galah-x/weatherino/weatherino.pdf

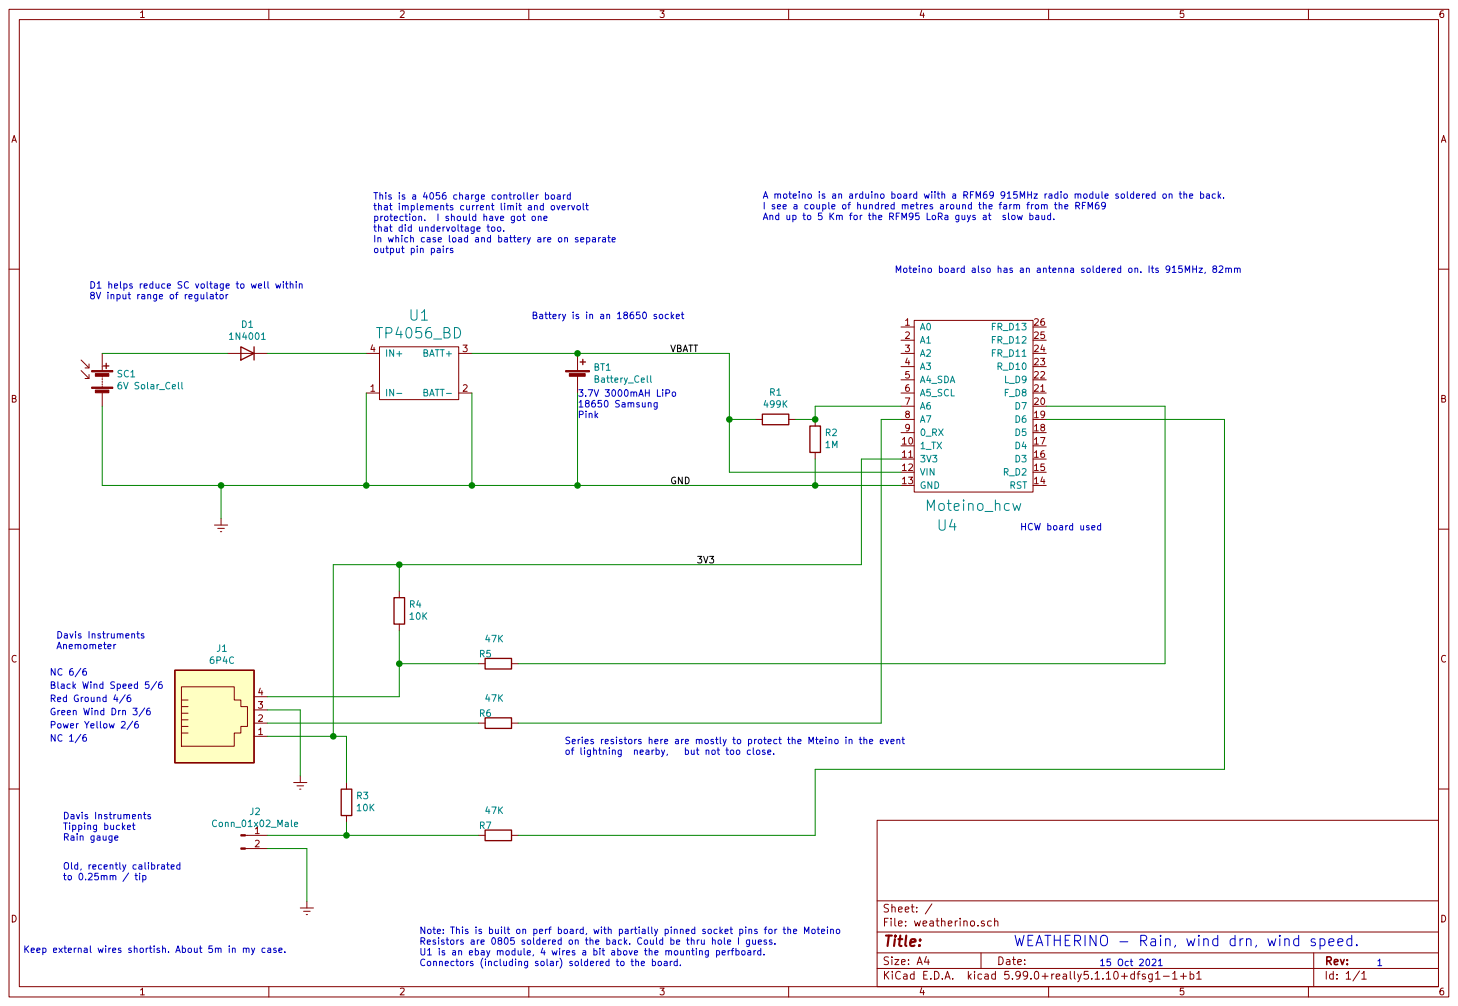
[picture p1: page 1]

8V input range of regulator Davis Instruments Anemometer Davis Instruments Tipping bucket

This is a 4056 charge controller board
that implements current limit and overvolt
protection. I should have got one
that did undervoltage too.
In which case load and battery are on separate
output pin pairs

A moteino is an arduino board wiith a RFM69 915MHz radio module soldered on the back.
I see a couple of hundred metres around the farm from the RFM69
And up to 5 Km for the RFM95 LoRa guys at slow baud.

Moteino board also has an antenna soldered on. Its 915MHz, 82mm

3.7V 3000mAH LiPo 18650 Samsung Pink Red Ground 4/6 Black Wind Speed 5/6 NC 6/6 NC 1/6

Series resistors here are mostly to protect the Mteino in the event
of lightning nearby, but not too close.

Id: 1/1 Title: File: weatherino.sch Sheet: /

Note: This is built on perf board, with partially pinned socket pins for the Moteino
Resistors are 0805 soldered on the back. Could be thru hole I guess.
U1 is an ebay module, 4 wires a bit above the mounting perfboard.
Connectors (including solar) soldered to the board.

Keep external wires shortish. About 5m in my case.
