galah-x/weatherino/(commit log)

2019-02-25 draw schematic of weatherino_temperature
    [weatherino.kicad_pcb, weatherino.sch]
2019-03-23 realize both interrupts are now on the same vector
2019-10-25 and even add the files themselves
    [sine.ods]
2021-08-12 modified scaling according to raingauge cal
    [sine.ods]
2021-10-10 experiment with various power save modes, get current from 24 to 4mA
2021-10-12 switch to 1S battery, the 12V 4.5AH seems stuffed
2021-10-15 update schematic
    [weatherino.sch, weatherino_temperature.sch]
2021-10-24 address emi susceptibility and contact bounce on rain.
    [weatherino.sch]
